ricomputermuseum/RICM_greenpower_telemetry/parts.xlsx

Part | Cost | Quantity | part cost | Link | Notes
Raspberry Pi Pico | $4.00 | 1 | $4.00
I2C Accelerometer/gyro | $3.33 | 1 | $3.33 | https://www.amazon.com/HiLetgo-MPU-6050-Accelerometer-Gyroscope-Converter/dp/B00LP25V1A?hvadid=247487538123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 | $10 for 3 | https://lastminuteengineers.com/mpu6050-accel-gyro-arduino-tutorial/
SD card breakout | $3.00 | 1 | $3.00 | https://www.digikey.com/en/products/detail/adafruit-industries-llc/4682/12822319?WT.mc_id=frommaker.io | Can write directly from the SPI bus
thermistor | $4.00 | 3 | $12.00 | https://www.adafruit.com/product/372 | cheaper and simpler than using a thermocouple
Hall effect sensor | $1.00 | 2 | $2.00 | https://www.digikey.com/en/products/detail/melexis-technologies-nv/US5881LUA-AAA-000-BU/431876 | Can use 1 on the motor or 2 for motor and axle | https://maker.pro/arduino/tutorial/how-to-use-a-hall-effect-sensor-with-arduino
Current Sensor | $25.50 | 1 | $25.50 | https://www.digikey.com/en/products/detail/lem-usa-inc/HAIS-50-P/1026520
Voltage Sensor IC | $6.70 | 1 | $6.70 | https://www.digikey.com/en/products/detail/analog-devices-inc/LTC2990CMS-TRPBF/2407346 | 4 channels, 2 for the battery and 2 for the ref and measurement on the current sensor
Total | $56.53
