ricomputermuseum/RICM_greenpower_telemetry/RICM Greenpower Telemetry Module/RICM Greenpower Instrument Cluster/gerbers/RICM Greenpower Instrument Cluster-Edge_Cuts.dxf

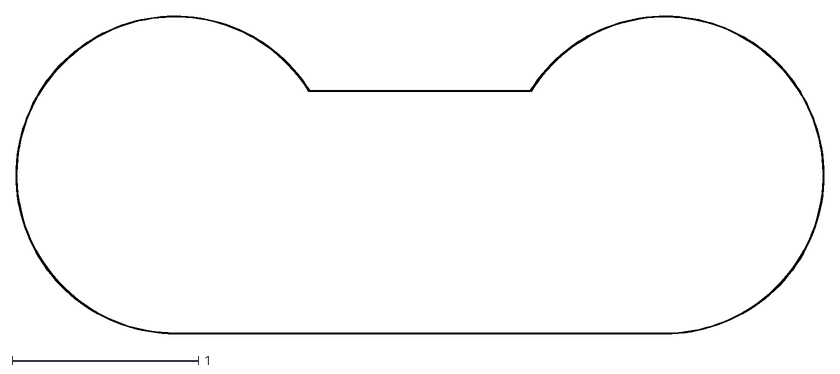
[picture p7: CAD file, 2024-07-16]
RICM Greenpower Telemetry Module/RICM Greenpower Instrument Cluster/gerbers/RICM Greenpower Instrument Cluster-Edge_Cuts.dxf
4.33 x 1.70
