ricomputermuseum/RICM_greenpower_telemetry/(list of files, cad)

Other CAD files:
RICM Greenpower Telemetry Module/RICM Greenpower Instrument Cluster/gerbers/RICM Greenpower Instrument Cluster-F_Mask.dxf
kicad parts/KiCad-RP-Pico-main/SketchUp Model/Pico.skp
