ricomputermuseum/RICM_greenpower_telemetry/pinout_guide.png

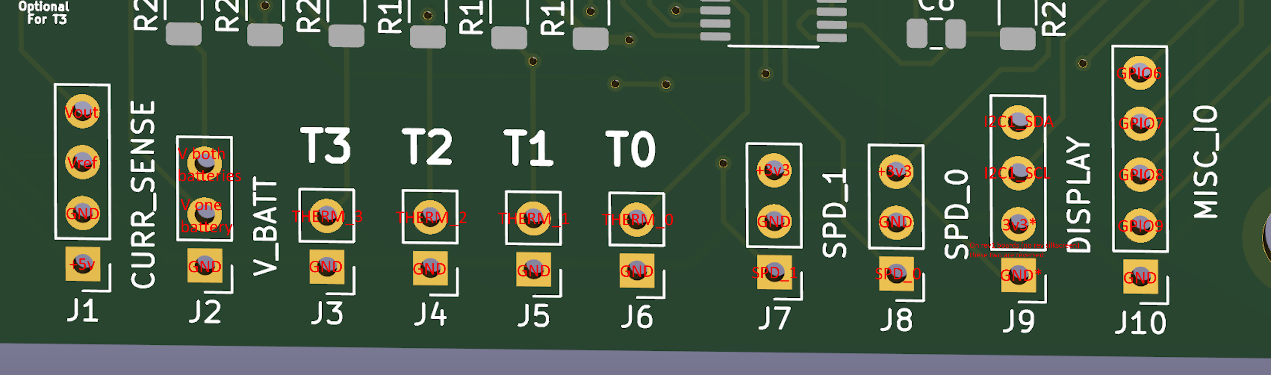
pinout_guide.png
