ricomputermuseum/RICM_greenpower_telemetry/RICM Greenpower Telemetry Module/pinout_guide.png

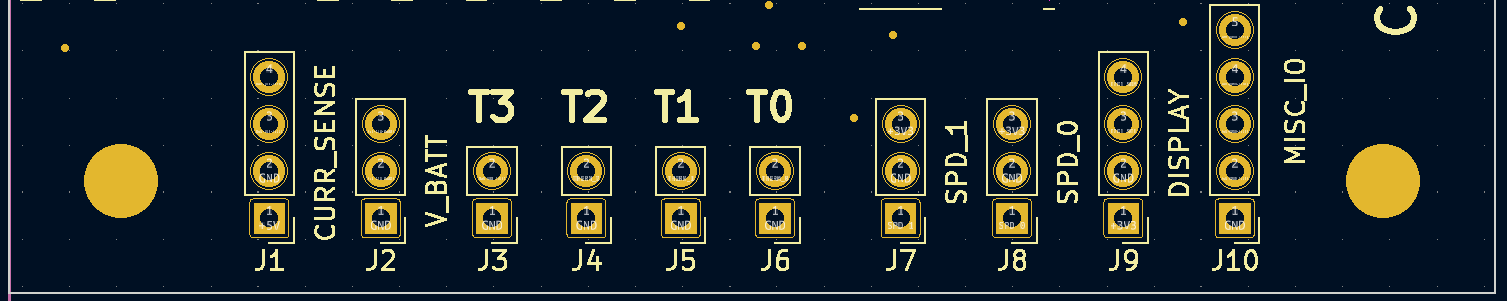
RICM Greenpower Telemetry Module/pinout_guide.png
