ricomputermuseum/RICM_greenpower_telemetry/RICM Greenpower Telemetry Module/RICM Greenpower Telemetry Module.pdf

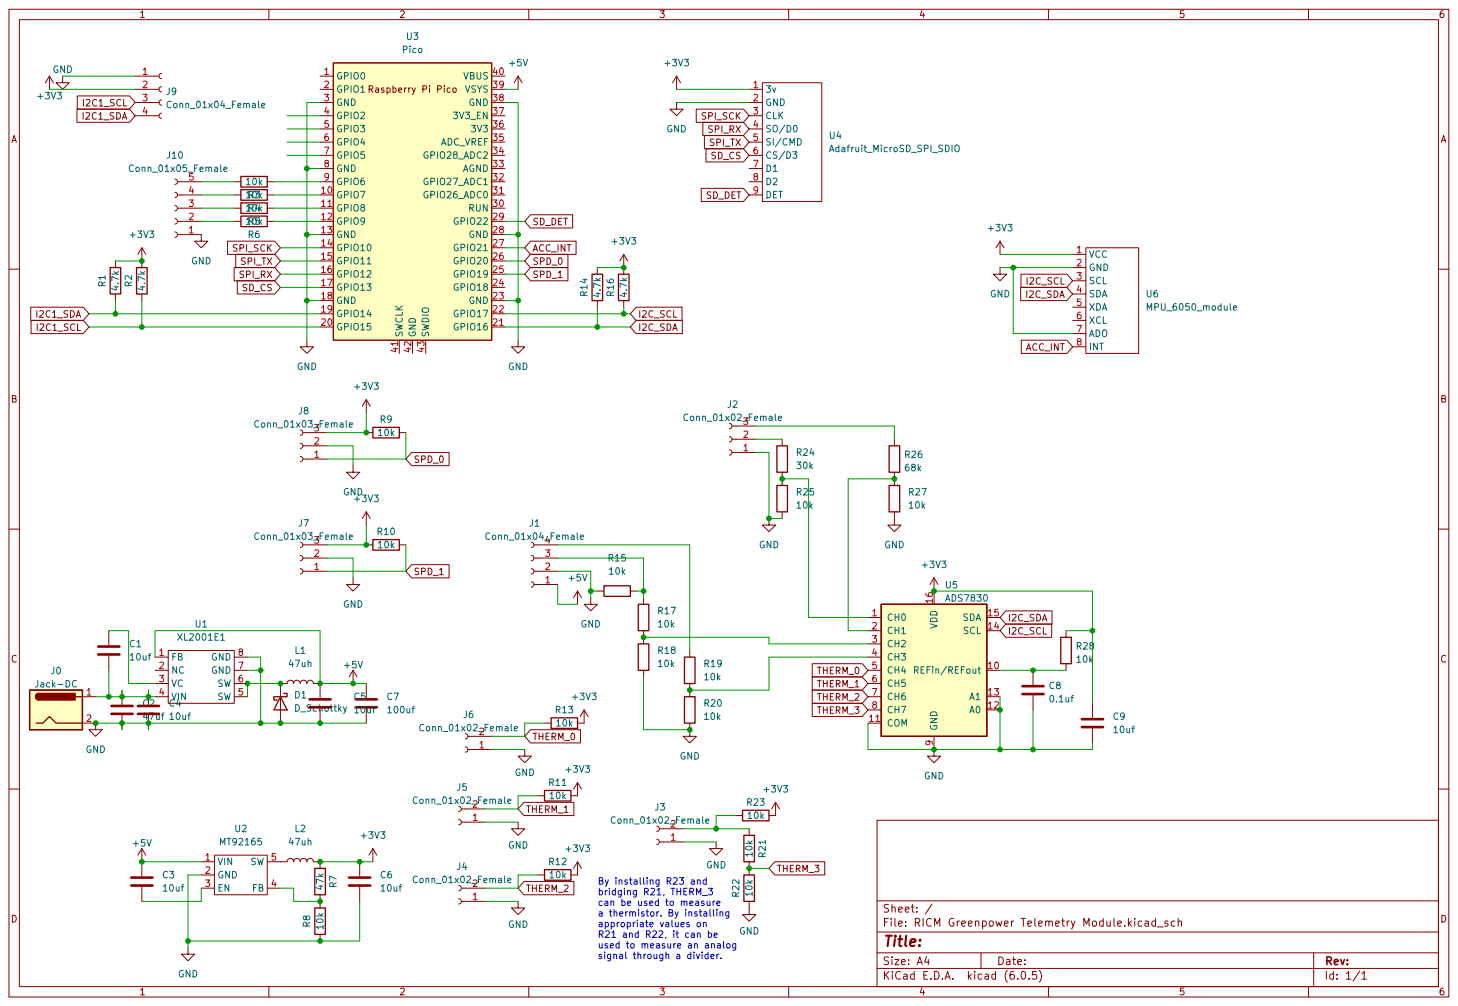
[picture p23: page 1]

File: RICM Greenpower Telemetry Module.kicad_sch Sheet: / +3V3

bridging R21, THERM_3
can be used to measure
a thermistor. By installing
appropriate values on R21 and R22, it can be

used to measure an analog
signal through a divider.
