ricomputermuseum/RICM_greenpower_telemetry/RICM Greenpower Telemetry Module/gerbers/RICM Greenpower Telemetry Module-F_Silkscreen.pdf

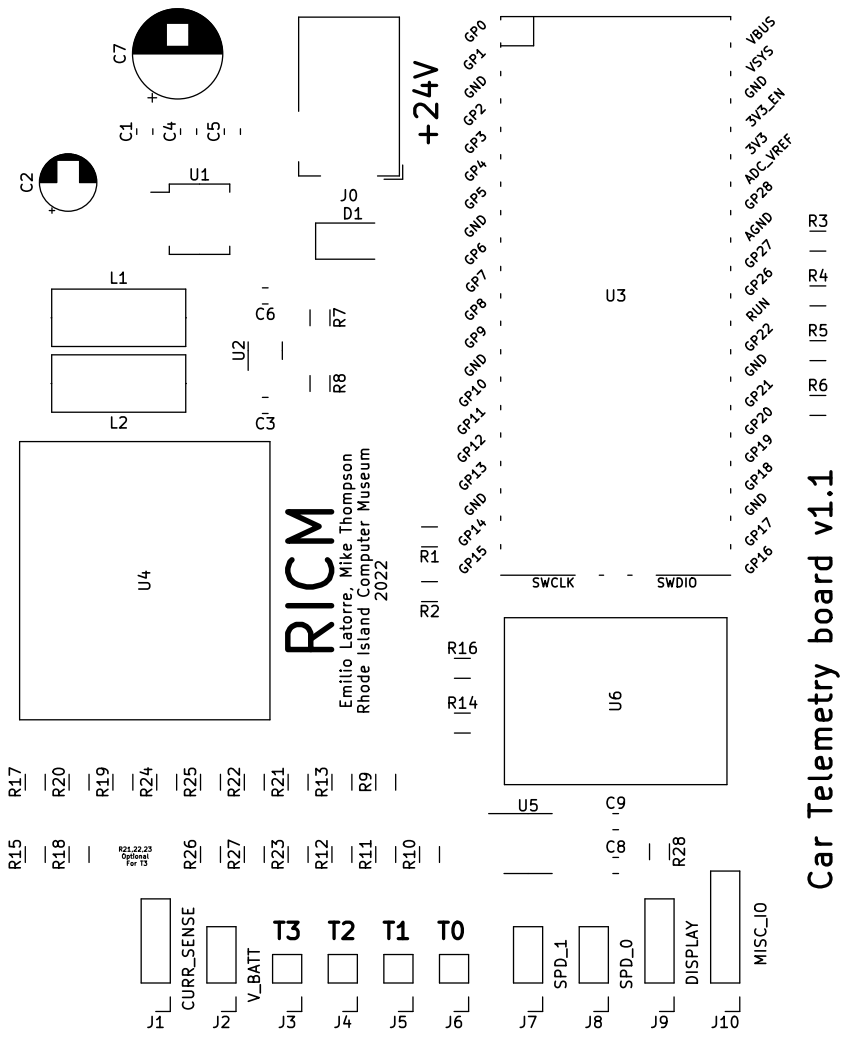
[picture p24: page 1]

DISPLAYT0 Car Telemetry board v1.1 V_BATT Emilio Latorre, Mike Thompson Rhode Island Computer Museum 2022 +24V
