ricomputermuseum/RICM_greenpower_telemetry/kicad parts/KiCad-RP-Pico-main/RP-Pico Libraries/diagram.pdf

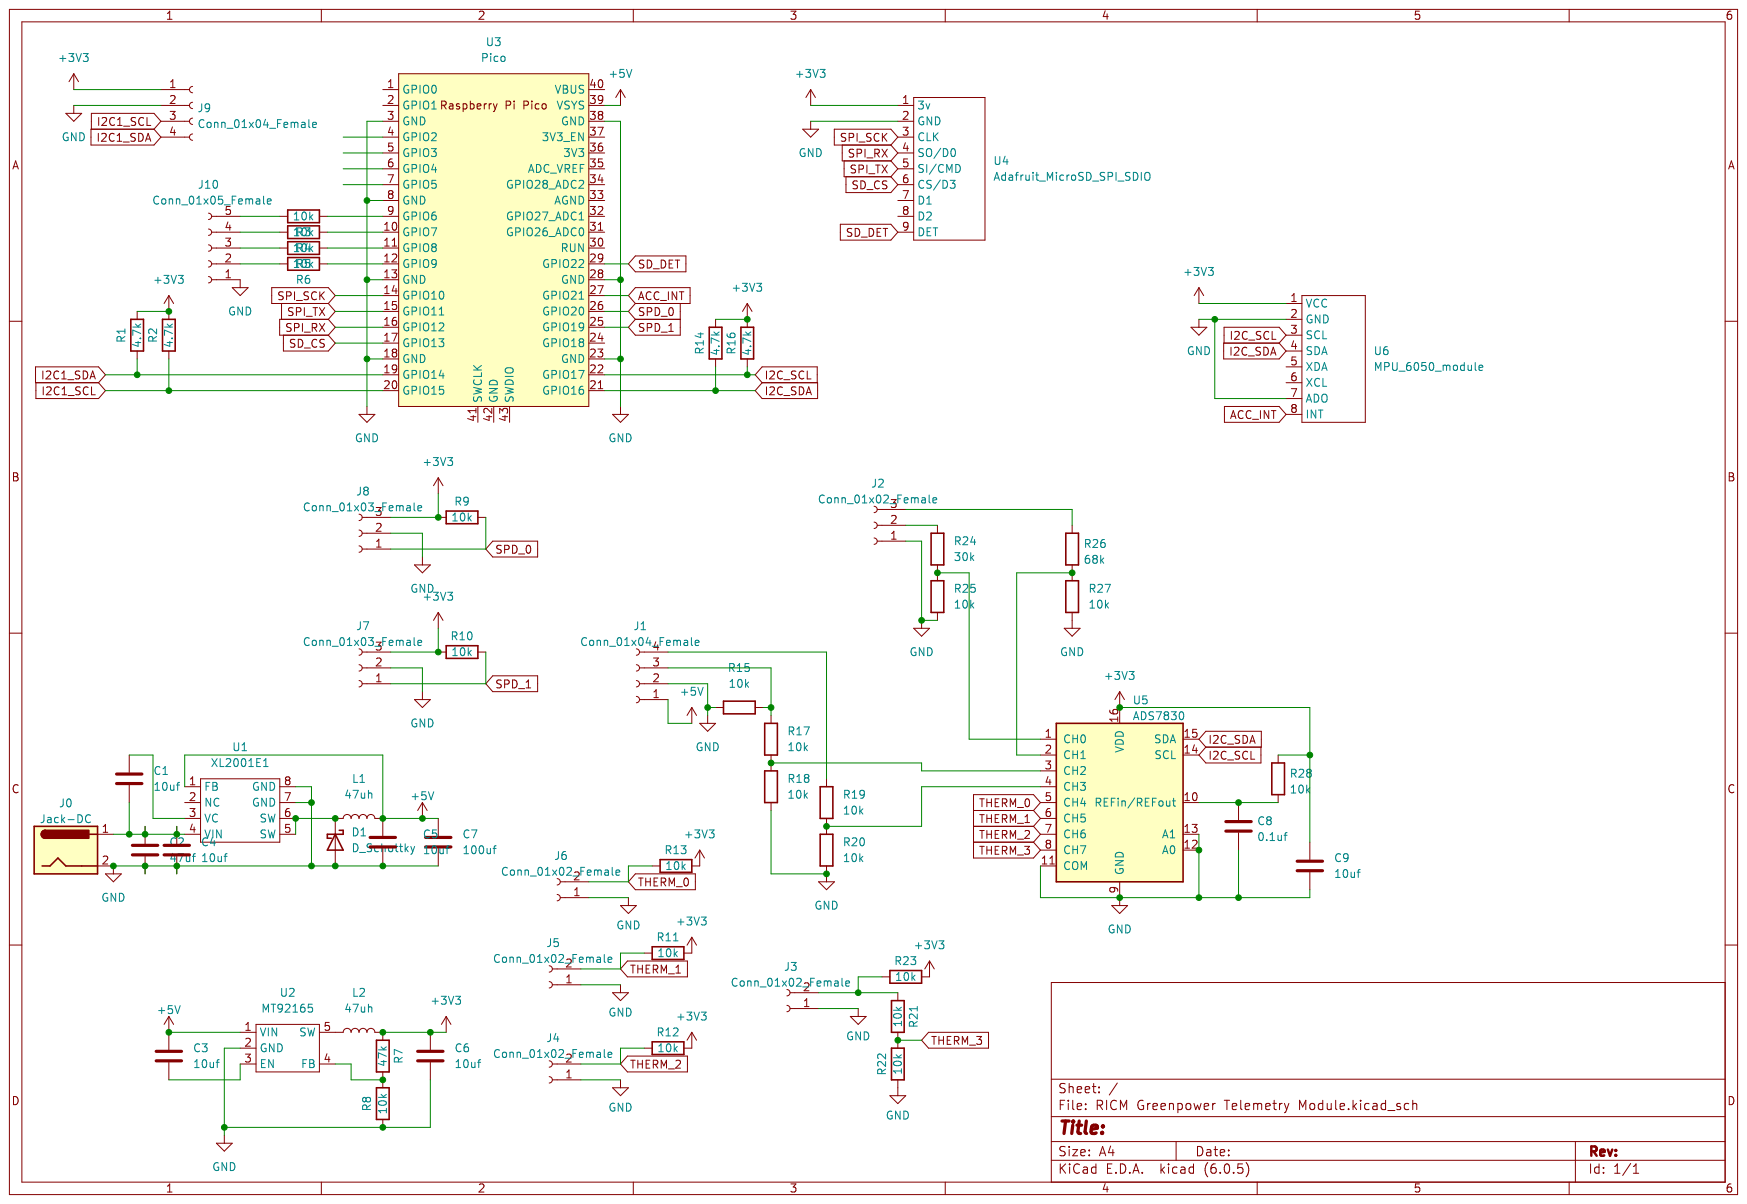
[picture p25: page 1]
