ricomputermuseum/RICM_greenpower_telemetry/RICM Greenpower Telemetry Module/board.pdf

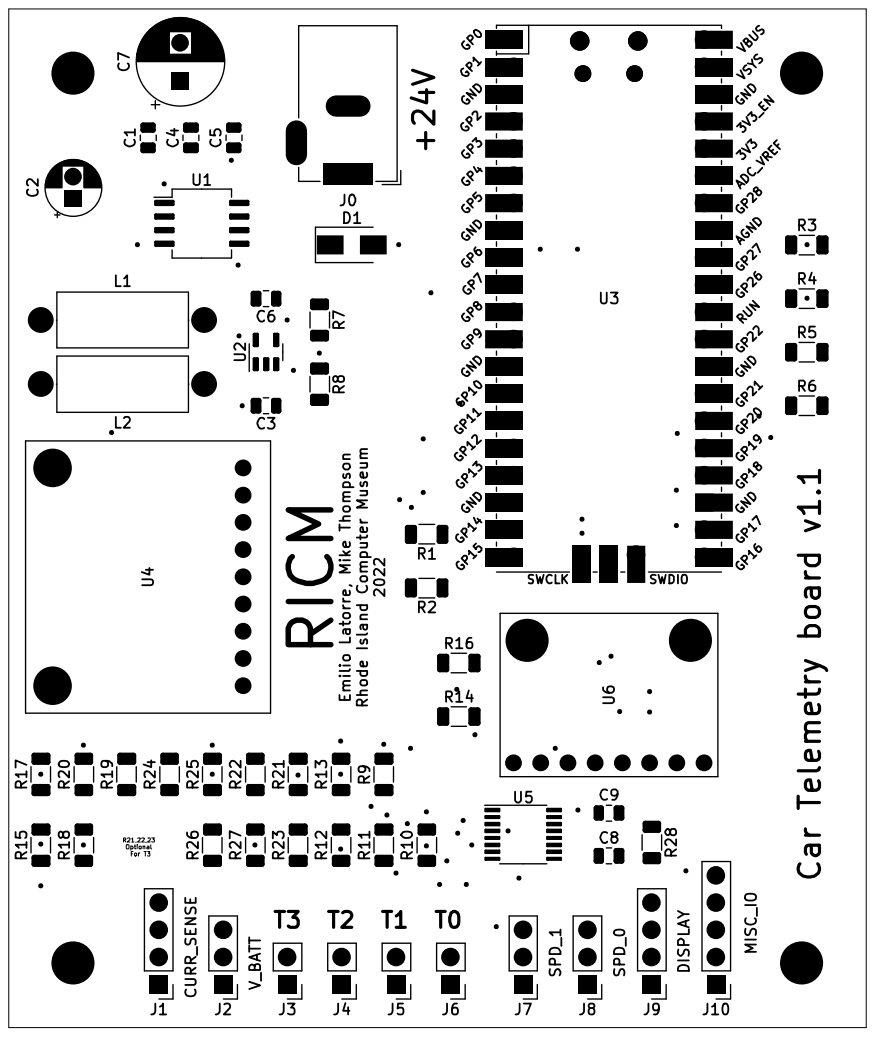
[picture p26: page 1]
