ricomputermuseum/RICM_greenpower_telemetry/RICM Greenpower Telemetry Module/gerbers/RICM Greenpower Telemetry Module-F_Cu.pdf

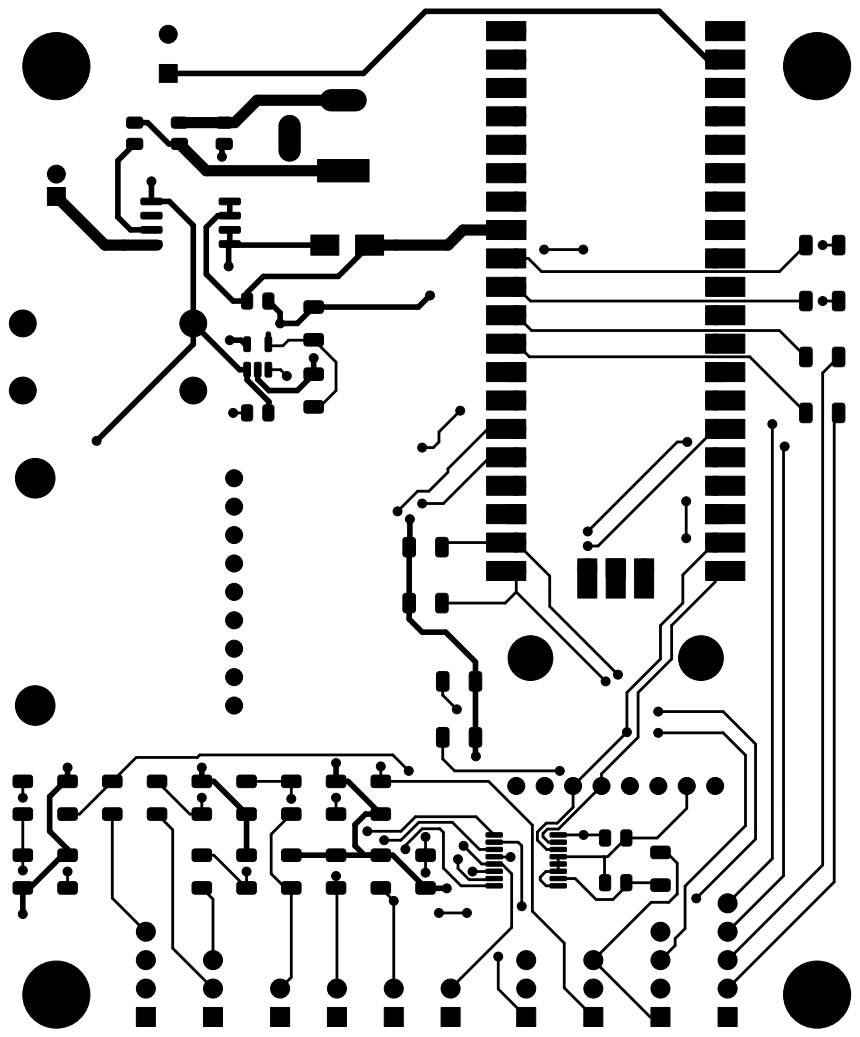
[picture p27: page 1]
