ricomputermuseum/RICM_greenpower_telemetry/RICM Greenpower Telemetry Module/gerbers/RICM Greenpower Telemetry Module-B_Cu.pdf

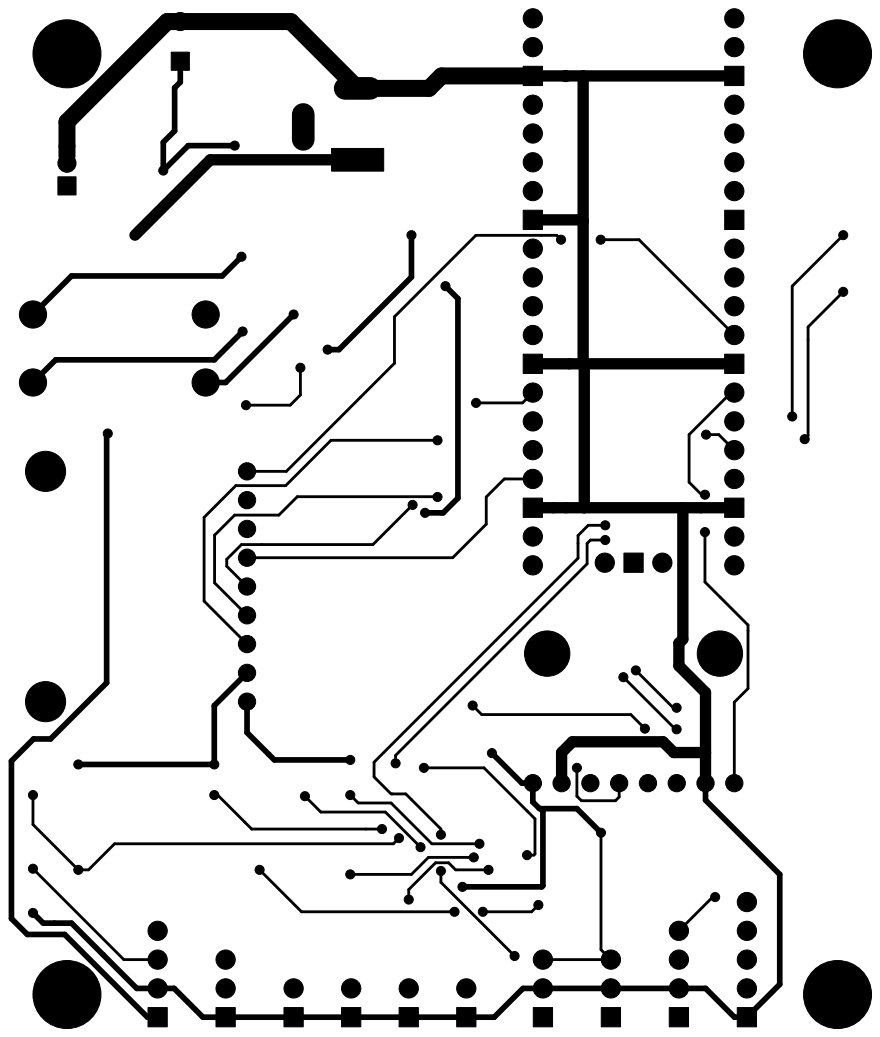
[picture p28: page 1]
