ricomputermuseum/RICM_greenpower_telemetry/RICM Greenpower Telemetry Module/gerbers/RICM Greenpower Telemetry Module-B_Mask.pdf

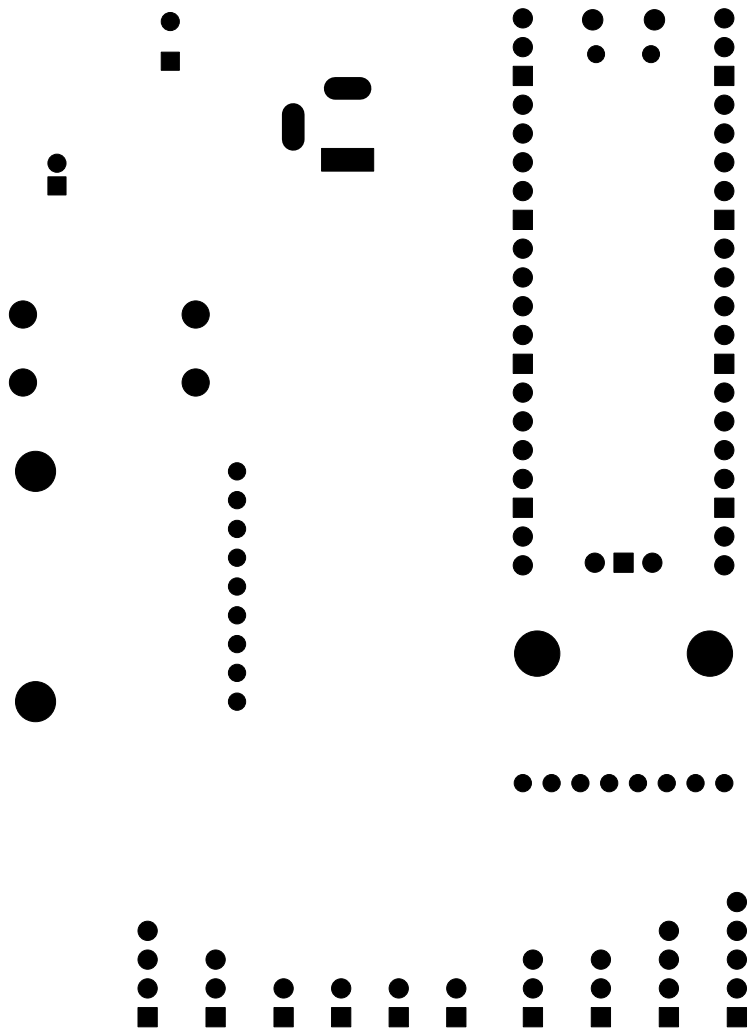
[picture p29: page 1]
