ricomputermuseum/RICM_greenpower_telemetry/RICM Greenpower Telemetry Module/gerbers/RICM Greenpower Telemetry Module-F_Mask.pdf

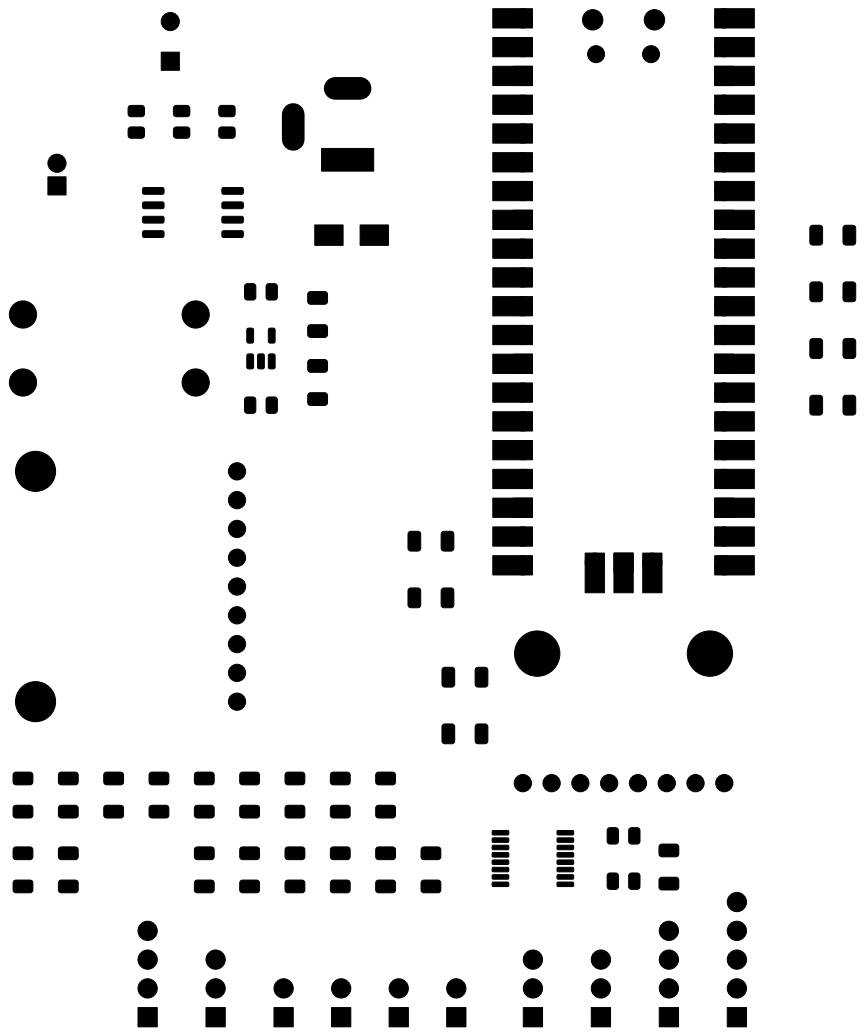
[picture p30: page 1]
