ricomputermuseum/RICM_greenpower_telemetry/RICM Greenpower Telemetry Module/RICM Greenpower Instrument Cluster/RICM Greenpower Instrument Cluster.kicad_pcb

## KiCad design RICM Greenpower Telemetry Module/RICM Greenpower Instrument Cluster/RICM Greenpower Instrument Cluster.kicad_pcb (2024-07-16)

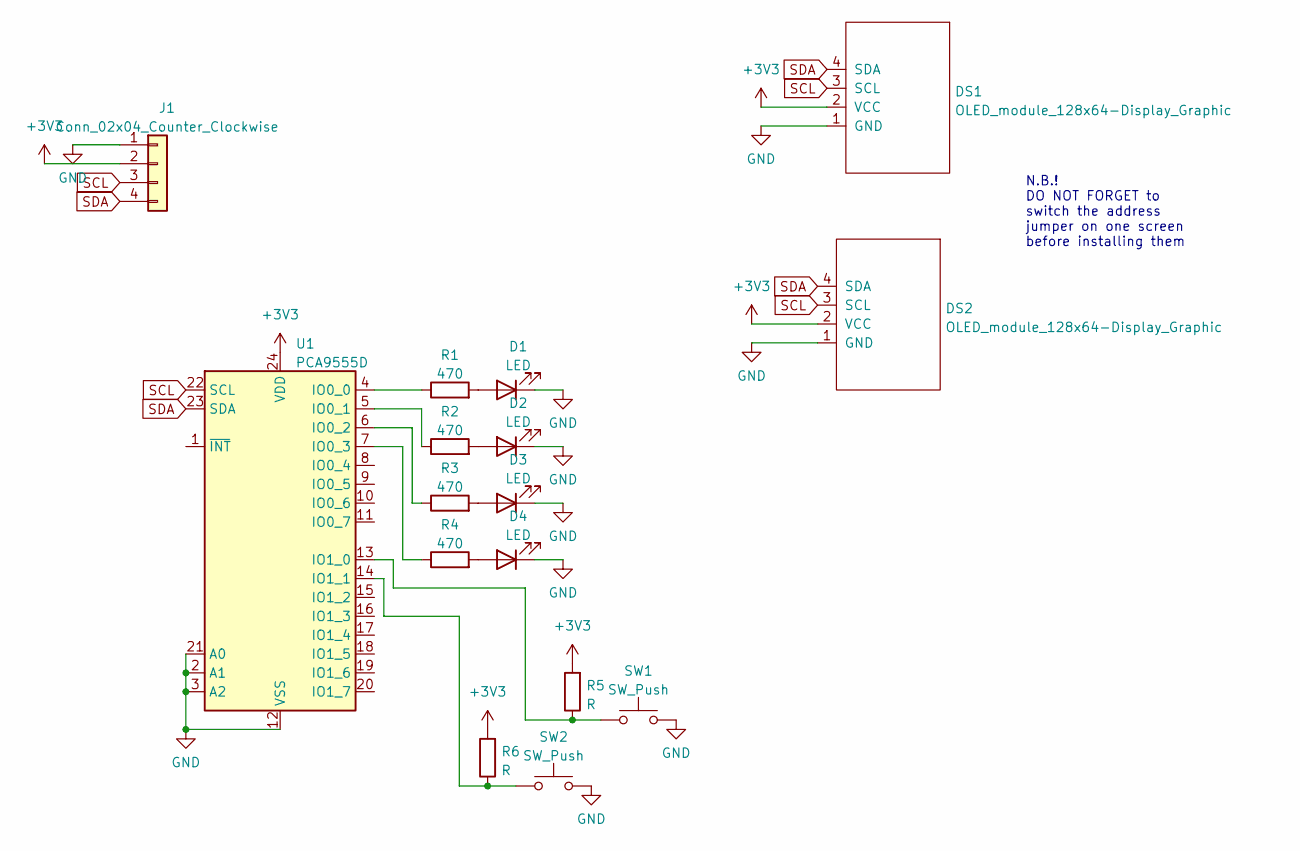
[picture p32: schematic RICM Greenpower Instrument Cluster.kicad_sch]

Parts:
D1, D2, D3, D4: LED; LED_D5.0mm
DS1, DS2: OLED_module_128x64-Display_Graphic; OLED__module_128x64
J1: Conn_02x04_Counter_Clockwise; PinHeader_1x04_P2.54mm_Vertical
R1, R2, R3, R4: 470; R_Axial_DIN0207_L6.3mm_D2.5mm_P7.62mm_Horizontal
R5, R6: R; R_Axial_DIN0207_L6.3mm_D2.5mm_P7.62mm_Horizontal
SW1, SW2: SW_Push; SW_PUSH_6mm_2pin
U1: PCA9555D; SOIC-24W_7.5x15.4mm_P1.27mm

Connections:
+3V3: DS1.2 (VCC), DS2.2 (VCC), J1.2, U1.24 (VDD)
+5V: R5.2, R6.2
GND: D1.1 (K), D2.1 (K), D3.1 (K), D4.1 (K), DS1.1 (GND), DS2.1 (GND), J1.1, SW1.2, SW2.2, U1.2 (A1), U1.3 (A2), U1.12 (VSS), U1.21 (A0)
unnamed: D1.2 (A), R1.2
unnamed: D2.2 (A), R2.2
unnamed: D3.2 (A), R3.2
unnamed: D4.2 (A), R4.2
unnamed: R1.1, U1.4 (IO0_0)
unnamed: R2.1, U1.5 (IO0_1)
unnamed: R3.1, U1.6 (IO0_2)
unnamed: R4.1, U1.7 (IO0_3)
unnamed: R5.1, SW1.1, U1.13 (IO1_0)
unnamed: R6.1, SW2.1, U1.14 (IO1_1)
SCL: DS1.3 (SCL), DS2.3 (SCL), J1.3, U1.22 (SCL)
SDA: DS1.4 (SDA), DS2.4 (SDA), J1.4, U1.23 (SDA)

Notes on the sheet:
N.B.! DO NOT FORGET to switch the address jumper on one screen before installing them

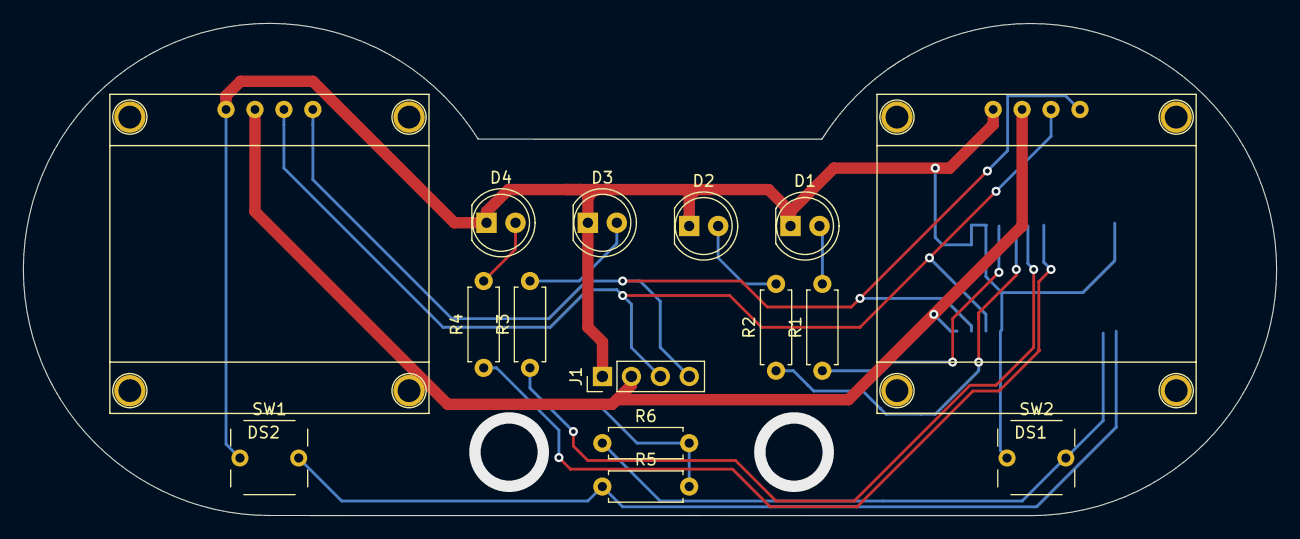
[picture p33: board RICM Greenpower Instrument Cluster.kicad_pcb from above]

Board: 2 copper layers, 110.0 x 43.2 mm, 16 parts (1 on the bottom side), 15 nets.
