ricomputermuseum/RICM_greenpower_telemetry/RICM Greenpower Telemetry Module/RICM Greenpower Telemetry Module.kicad_pcb

## KiCad design RICM Greenpower Telemetry Module/RICM Greenpower Telemetry Module.kicad_pcb (2024-07-16)

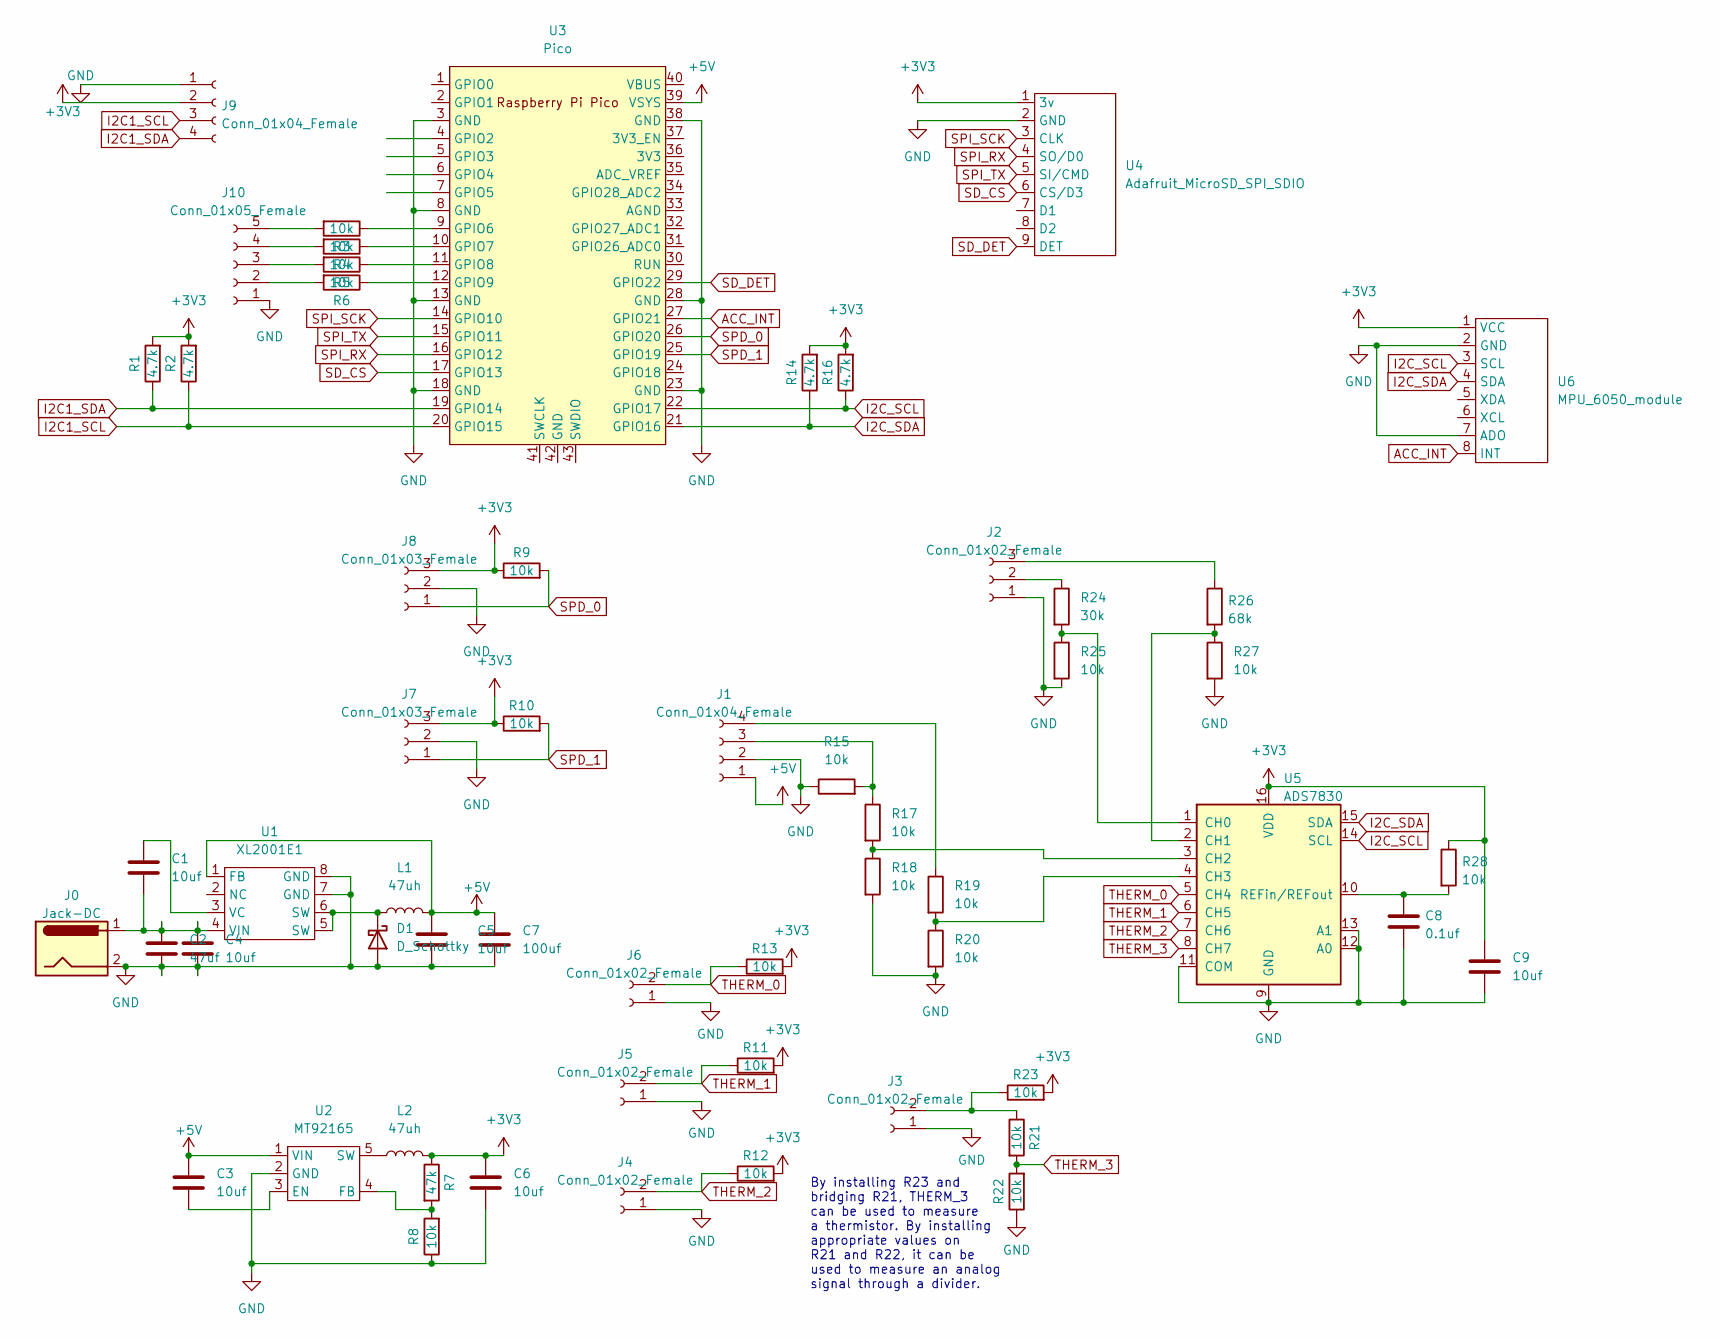
[picture p34: schematic RICM Greenpower Telemetry Module.kicad_sch]

Parts:
C1, C3, C4, C5, C6, C9: 10uf; C_0805_2012Metric
C2: 47uf; CP_Radial_D5.0mm_P2.00mm
C7: 100uf; CP_Radial_D8.0mm_P3.50mm
C8: 0.1uf; C_0805_2012Metric
D1: D_Schottky; D_SMA
J0: Jack-DC; BarrelJack_GCT_DCJ200-10-A_Horizontal
J1, J9: Conn_01x04_Female; PinHeader_1x04_P2.54mm_Vertical
J2: Conn_01x02_Female; PinHeader_1x03_P2.54mm_Vertical
J3, J4, J5, J6: Conn_01x02_Female; PinHeader_1x02_P2.54mm_Vertical
J7, J8: Conn_01x03_Female; PinHeader_1x03_P2.54mm_Vertical
J10: Conn_01x05_Female; PinHeader_1x05_P2.54mm_Vertical
L1, L2: 47uh; L_Axial_L12.0mm_D5.0mm_P15.24mm_Horizontal_Fastron_MISC
R1, R2, R14, R16: 4.7k; R_1206_3216Metric
R3, R4, R5, R6, R8, R9, R10, R11, R12, R13, R15, R17, R18, R19, R20, R21, R22, R23, R25, R27, R28: 10k; R_1206_3216Metric
R7: 47k; R_1206_3216Metric
R24: 30k; R_1206_3216Metric
R26: 68k; R_1206_3216Metric
U1: XL2001E1; SO-8_5.3x6.2mm_P1.27mm
U2: MT92165; SOT-23-5
U3: Pico; RPi_Pico_SMD_TH
U4: Adafruit_MicroSD_SPI_SDIO; Adafruit_MicroSD_breakout
U5: ADS7830; TSSOP-16_4.4x5mm_P0.65mm
U6: MPU_6050_module

Connections:
+3V3: C6.1, C9.1, J7.3, J8.3, J9.2, L2.2, R1.2, R2.2, R7.1, R9.1, R10.1, R11.2, R12.2, R13.2, R14.2, R16.2, R23.2, R28.1, U4.1 (3v), U5.16 (VDD), U6.1 (VCC)
+5V: C3.1, C5.1, C7.1, J1.1, L1.2, U1.1 (FB), U2.1 (VIN), U3.39 (VSYS)
ACC_INT: U3.27 (GPIO21), U6.8 (INT)
GND: C2.2, C4.2, C5.2, C6.2, C7.2, C8.1, C9.2, D1.2 (A), J0.2, J1.2, J2.1, J3.1, J4.1, J5.1, J6.1, J7.2, J8.2, J9.1, J10.1, R8.1, R15.1, R18.2, R20.2, R22.1, R25.2, R27.2, U1.7 (GND), U1.8 (GND), U2.2 (GND), U3.3 (GND), U3.8 (GND), U3.13 (GND), U3.18 (GND), U3.23 (GND), U3.28 (GND), U3.38 (GND), U4.2 (GND), U5.9 (GND), U5.11 (COM), U5.12 (A0), U5.13 (A1), U6.2 (GND), U6.7 (ADO)
I2C1_SCL: J9.3, R2.1, U3.20 (GPIO15)
I2C1_SDA: J9.4, R1.1, U3.19 (GPIO14)
I2C_SCL: R16.1, U3.22 (GPIO17), U5.14 (SCL), U6.3 (SCL)
I2C_SDA: R14.1, U3.21 (GPIO16), U5.15 (SDA), U6.4 (SDA)
unnamed: C1.1, U1.3 (VC)
unnamed: C1.2, C2.1, C4.1, J0.1, U1.4 (VIN)
unnamed: C3.2, U2.3 (EN)
unnamed: C8.2, R28.2, U5.10 (REFin/REFout)
unnamed: D1.1 (K), L1.1, U1.5 (SW), U1.6 (SW)
unnamed: J1.3, R15.2, R17.1
unnamed: J1.4, R19.1
unnamed: J2.2, R24.1
unnamed: J2.3, R26.1
unnamed: J3.2, R21.1, R23.1
unnamed: J10.2, R6.2
unnamed: J10.3, R5.2
unnamed: J10.4, R4.2
unnamed: J10.5, R3.2
unnamed: L2.1, U2.5 (SW)
unnamed: R3.1, U3.9 (GPIO6)
unnamed: R4.1, U3.10 (GPIO7)
unnamed: R5.1, U3.11 (GPIO8)
unnamed: R6.1, U3.12 (GPIO9)
unnamed: R7.2, R8.2, U2.4 (FB)
unnamed: R17.2, R18.1, U5.3 (CH2)
unnamed: R19.2, R20.1, U5.4 (CH3)
unnamed: R24.2, R25.1, U5.1 (CH0)
unnamed: R26.2, R27.1, U5.2 (CH1)
SD_CS: U3.17 (GPIO13), U4.6 (CS/D3)
SD_DET: U3.29 (GPIO22), U4.9 (DET)
SPD_0: J8.1, R9.2, U3.26 (GPIO20)
SPD_1: J7.1, R10.2, U3.25 (GPIO19)
SPI_RX: U3.16 (GPIO12), U4.4 (SO/D0)
SPI_SCK: U3.14 (GPIO10), U4.3 (CLK)
SPI_TX: U3.15 (GPIO11), U4.5 (SI/CMD)
THERM_0: J6.2, R13.1, U5.5 (CH4)
THERM_1: J5.2, R11.1, U5.6 (CH5)
THERM_2: J4.2, R12.1, U5.7 (CH6)
THERM_3: R21.2, R22.2, U5.8 (CH7)

Notes on the sheet:
By installing R23 and bridging R21, THERM_3 can be used to measure a thermistor. By installing appropriate values on R21 and R22, it can be used to measure an analog signal through a divider.

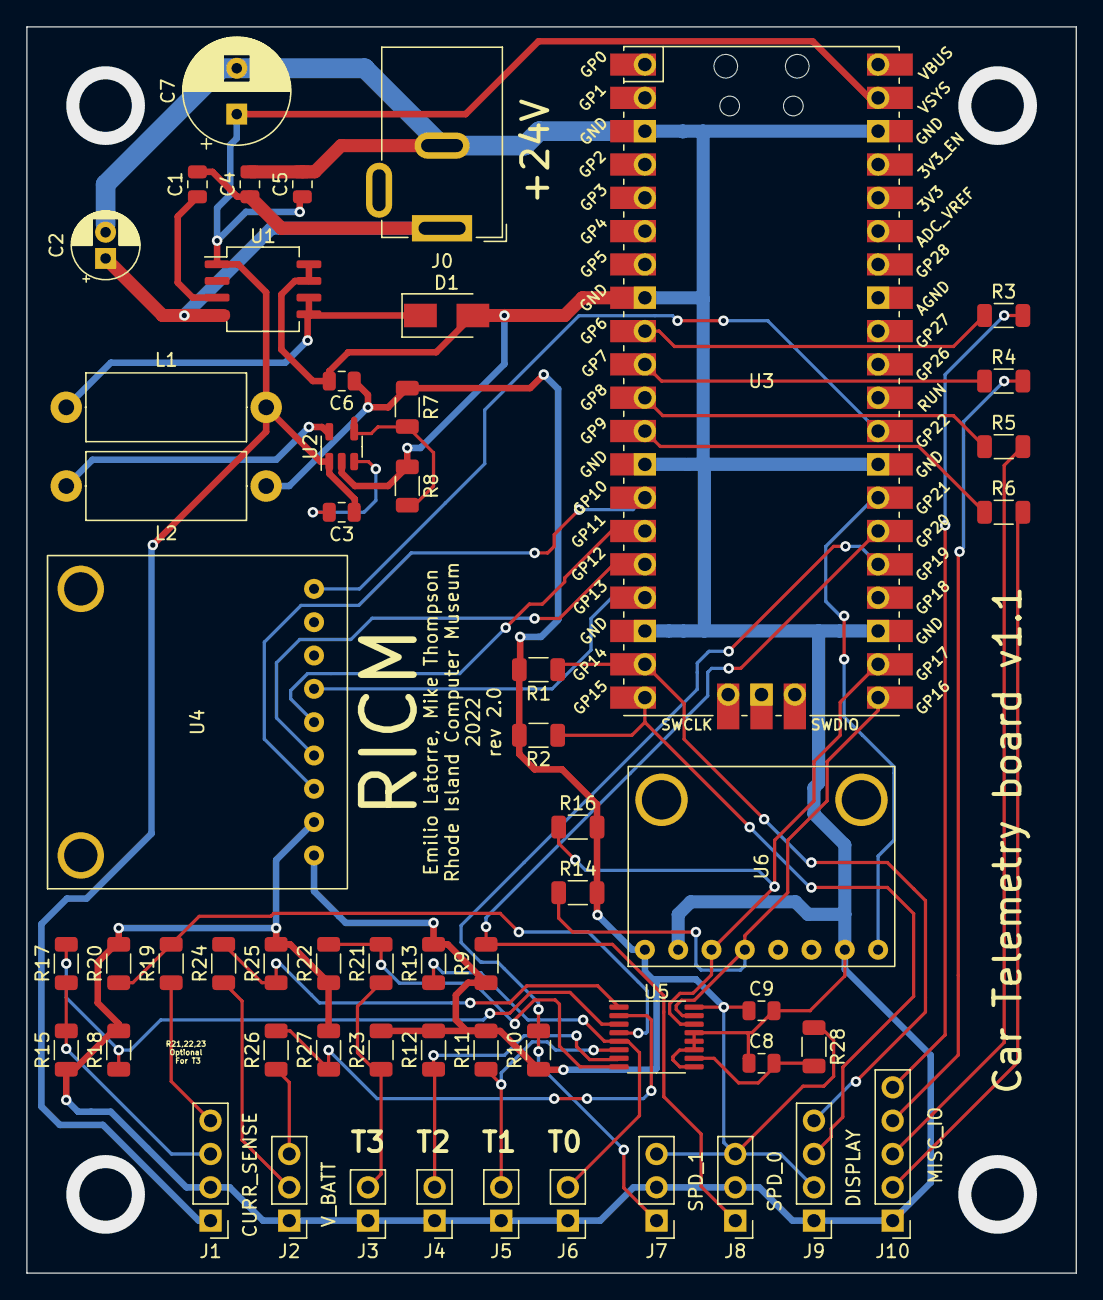
[picture p35: board RICM Greenpower Telemetry Module.kicad_pcb from above]

Board: 2 copper layers, 80.0 x 95.0 mm, 57 parts (0 on the bottom side), 43 nets.
