ricomputermuseum/RICM_greenpower_telemetry/kicad parts/KiCad-RP-Pico-main/Test/Test.kicad_pcb

## KiCad design kicad parts/KiCad-RP-Pico-main/Test/Test.kicad_pcb (2022-05-19)


Parts:
J1, J2: Conn_01x20; PinSocket_1x20_P1.00mm_Vertical
J3: Conn_01x03; PinSocket_1x03_P1.00mm_Vertical
U1: Pico; RPi_Pico_SMD_TH

Connections:
GND: J1.3, J1.8, J1.13, J1.18, J2.3, J2.13, J2.18, J3.2, U1.3 (GND), U1.8 (GND), U1.13 (GND), U1.18 (GND), U1.23 (GND), U1.28 (GND), U1.38 (GND), U1.42 (GND)
unnamed: J1.1, U1.1 (GPIO0)
unnamed: J1.2, U1.2 (GPIO1)
unnamed: J1.4, U1.4 (GPIO2)
unnamed: J1.5, U1.5 (GPIO3)
unnamed: J1.6, U1.6 (GPIO4)
unnamed: J1.7, U1.7 (GPIO5)
unnamed: J1.9, U1.9 (GPIO6)
unnamed: J1.10, U1.10 (GPIO7)
unnamed: J1.11, U1.11 (GPIO8)
unnamed: J1.12, U1.12 (GPIO9)
unnamed: J1.14, U1.14 (GPIO10)
unnamed: J1.15, U1.15 (GPIO11)
unnamed: J1.16, U1.16 (GPIO12)
unnamed: J1.17, U1.17 (GPIO13)
unnamed: J1.19, U1.19 (GPIO14)
unnamed: J1.20, U1.20 (GPIO15)
unnamed: J2.1, U1.40 (VBUS)
unnamed: J2.2, U1.39 (VSYS)
unnamed: J2.4, U1.37 (3V3_EN)
unnamed: J2.5, U1.36 (3V3)
unnamed: J2.6, U1.35 (ADC_VREF)
unnamed: J2.7, U1.34 (GPIO28_ADC2)
unnamed: J2.8, U1.33 (AGND)
unnamed: J2.9, U1.32 (GPIO27_ADC1)
unnamed: J2.10, U1.31 (GPIO26_ADC0)
unnamed: J2.11, U1.30 (RUN)
unnamed: J2.12, U1.29 (GPIO22)
unnamed: J2.14, U1.27 (GPIO21)
unnamed: J2.15, U1.26 (GPIO20)
unnamed: J2.16, U1.25 (GPIO19)
unnamed: J2.17, U1.24 (GPIO18)
unnamed: J2.19, U1.22 (GPIO17)
unnamed: J2.20, U1.21 (GPIO16)
unnamed: J3.1, U1.43 (SWDIO)
unnamed: J3.3, U1.41 (SWCLK)


Board: 2 copper layers, 43.0 x 65.0 mm, 4 parts (0 on the bottom side), 36 nets.
