ricomputermuseum/RICM_greenpower_telemetry/software_arduino/main/display_assets.h

const uint8_t PROGMEM logo_bitmap_RICM[1024]={
0xFF, 0xFF, 0xFF, 0xFF, 0xFF, 0xFF, 0xFF, 0xFF, 0xFF, 0xFF, 0xFF, 0xFF, 0xFF, 0xFF, 0xFF, 0xFF,
0xFF, 0xFF, 0xFF, 0xFF, 0xFF, 0xFF, 0xFF, 0xFF, 0xFF, 0xFF, 0xFF, 0xFF, 0xFF, 0xFF, 0xFF, 0xFF,
0xFF, 0xFF, 0xFF, 0xFF, 0xFF, 0xFF, 0xFF, 0xFF, 0xFF, 0xFF, 0xFF, 0xFF, 0xFF, 0xFF, 0xFF, 0xFF,
0xFF, 0xFF, 0xFF, 0xFF, 0xFF, 0xFF, 0xFF, 0xFF, 0xFF, 0xFF, 0xFF, 0xFF, 0xFF, 0xFF, 0xFF, 0xFF,
0xFF, 0xFF, 0xFF, 0xFF, 0xFF, 0xFF, 0xFF, 0xFF, 0xFF, 0xFF, 0xFF, 0xFF, 0xFF, 0xFF, 0xFF, 0xFF,
0xFF, 0xFF, 0xFF, 0xFF, 0xFF, 0xFF, 0xFF, 0xFF, 0xFF, 0xFF, 0xFF, 0xFF, 0xFF, 0xFF, 0xFF, 0xFF,
0xFF, 0xFF, 0xFF, 0xFF, 0xFF, 0xFF, 0xFF, 0xFF, 0xFF, 0xFF, 0xFF, 0xFF, 0xFF, 0xFF, 0xFF, 0xFF,
0xFF, 0xFF, 0xFF, 0xFF, 0xFF, 0xFF, 0xFF, 0xFF, 0xFF, 0xFF, 0xFF, 0xFF, 0xFF, 0xFF, 0xFF, 0xFF,
0xFF, 0xFF, 0xFF, 0xFF, 0xFF, 0xFF, 0xFF, 0xFF, 0xC0, 0x3F, 0xFF, 0xFF, 0xFF, 0xFF, 0xFF, 0xFF,
0xFF, 0x80, 0x00, 0x7F, 0xFF, 0x00, 0xFF, 0xFF, 0x00, 0x0F, 0xFC, 0x00, 0xFF, 0xF8, 0x01, 0xFF,
0xFF, 0x80, 0x00, 0x1F, 0xFF, 0x00, 0xFF, 0xFC, 0x00, 0x03, 0xFC, 0x00, 0xFF, 0xF8, 0x01, 0xFF,
0xFF, 0x80, 0x00, 0x07, 0xFF, 0x00, 0xFF, 0xF8, 0x00, 0x01, 0xFC, 0x00, 0xFF, 0xF8, 0x01, 0xFF,
0xFF, 0x80, 0x00, 0x03, 0xFF, 0x00, 0xFF, 0xF0, 0x00, 0x01, 0xFC, 0x00, 0x7F, 0xF0, 0x01, 0xFF,
0xFF, 0x80, 0x00, 0x03, 0xFF, 0x00, 0xFF, 0xE0, 0x00, 0x01, 0xFC, 0x00, 0x7F, 0xF0, 0x01, 0xFF,
0xFF, 0x80, 0x00, 0x01, 0xFF, 0x00, 0xFF, 0xC0, 0x00, 0x01, 0xFC, 0x00, 0x7F, 0xF0, 0x01, 0xFF,
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
0xFF, 0xFF, 0xFF, 0xFF, 0xFF, 0xE1, 0xFF, 0x8F, 0x83, 0xFC, 0x03, 0xFF, 0xFF, 0xFF, 0xFF, 0xFF,
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
};

const char disp_labels[][16] = {"speed","rpm","vBat0","vBat1","current","temp0","temp1","temp2","temp3","accX","accY","accZ","gyroX","gyroY","gyroZ","time"};
