ricomputermuseum/RICM_greenpower_telemetry/software_arduino/main/thermistor.h

//N.B. these values are calculated for an MF52-103J3950 thermistor with r25 of 10k
//if you use a different thermistor you will have to recalculate and update these values
//as thermistors are aggressively nonlinear (quartic is a good approximation) it is much cheaper computationally to use this table instead of calculating the temperature
//additionally because of this nonlinearity temperatures below 0*C cannot be accurately measured with an 8-bit reading
const float therm_readings[256] ={
    150.00,
    145.82,
    141.81,
    137.96,
    134.27,
    130.74,
    127.35,
    124.10,
    120.99,
    118.01,
    115.16,
    112.43,
    109.81,
    107.30,
    104.90,
    102.59,
    100.39,
    98.28,
    96.26,
    94.32,
    92.47,
    90.69,
    88.99,
    87.36,
    85.79,
    84.29,
    82.86,
    81.48,
    80.15,
    78.88,
    77.66,
    76.48,
    75.35,
    74.27,
    73.22,
    72.21,
    71.24,
    70.31,
    69.40,
    68.53,
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
};
