ricomputermuseum/RICM_greenpower_telemetry/(commit log)

2022-05-19 started on a layout
    [Pico.skp, RICM Greenpower Telemetry Module.kicad_pcb, RICM Greenpower Telemetry Module.kicad_sch, Test.kicad_pcb, Test.kicad_sch, parts.xlsx]
2022-05-20 added most of the sensors we will probably want
    3x temperature sensors
    2x hall effect (for RPM)
    2x battery voltage
    1x current (inductive loop, 50A)
    1x 3-axis gyro
    1x 3-axis accelerometer
    [RICM Greenpower Telemetry Module.kicad_sch, parts.xlsx]
2022-05-21 added more sensors and connectors
    Added all the sensors and connectors that will go on this board (for now). Next step, layout
    [RICM Greenpower Telemetry Module.kicad_pcb, RICM Greenpower Telemetry Module.kicad_sch]
2022-05-22 bug fixes and missing connections
    Fixed the short from the first battery voltage to ground
    Added a chip select for interfacing the SD card over SPI
    [RICM Greenpower Telemetry Module.kicad_pcb, RICM Greenpower Telemetry Module.kicad_sch]
2022-05-23 first draft of layout
    [RICM Greenpower Telemetry Module.kicad_pcb, RICM Greenpower Telemetry Module.kicad_sch]
2022-05-24 Polyfuse and missing connections
    [RICM Greenpower Telemetry Module.kicad_pcb, RICM Greenpower Telemetry Module.kicad_sch]
2022-06-07 laid out dial cluster
    [RICM Greenpower Instrument Cluster.kicad_pcb, RICM Greenpower Instrument Cluster.kicad_sch]
2022-07-13 update cluster
    Updated cluster schematic to use an I2C gpio expander. Added two pushbutton switches.
    [RICM Greenpower Instrument Cluster.kicad_pcb, RICM Greenpower Telemetry Module.kicad_pcb, RICM Greenpower Telemetry Module.kicad_sch, parts.xlsx]
2022-07-30 added onboard regulator
    Added onboard regulator and associated components. Added 4th thermistor connector.
    [RICM Greenpower Telemetry Module.kicad_pcb, RICM Greenpower Telemetry Module.kicad_sch]
2022-08-05 rearranged board to fit regulator
    [RICM Greenpower Telemetry Module-B_Cu.gbr, RICM Greenpower Telemetry Module-B_Mask.gbr, RICM Greenpower Telemetry Module-B_Paste.gbr, RICM Greenpower Telemetry Module-B_Silkscreen.gbr, RICM Greenpower Telemetry Module-Edge_Cuts.gbr, RICM Greenpower Telemetry Module-F_Cu.gbr, RICM Greenpower Telemetry Module-F_Mask.gbr, RICM Greenpower Telemetry Module-F_Paste.gbr]
2022-08-06 tightened up spacing on the board
    [RICM Greenpower Telemetry Module.kicad_pcb, RICM Greenpower Telemetry Module.kicad_sch]
2022-08-08 last revisions before first order
    [RICM Greenpower Instrument Cluster-B_Cu.gbr, RICM Greenpower Instrument Cluster-B_Mask.gbr, RICM Greenpower Instrument Cluster-B_Paste.gbr, RICM Greenpower Instrument Cluster-B_Silkscreen.gbr, RICM Greenpower Instrument Cluster-Edge_Cuts.gbr, RICM Greenpower Instrument Cluster-F_Cu.gbr, RICM Greenpower Instrument Cluster-F_Mask.gbr, RICM Greenpower Instrument Cluster-F_Paste.gbr]
2022-08-08 Added pullups for i2c
    [RICM Greenpower Telemetry Module.kicad_pcb, RICM Greenpower Telemetry Module.kicad_sch]
2022-08-08 started work on software
    Copied over the libraries for the gpio and oled modules. Added a library for the ADC chip. Started working on a module for the hall effect speedometer.
2022-08-09 more libraries
    Worked on the hall sensor and added a library for the thermistor.
2022-08-12 rearranged board
    Switched to sdm resistors and capacitors. Added a 3v3 regulated supply. Various other revisions.
    [RICM Greenpower Telemetry Module.kicad_pcb, RICM Greenpower Telemetry Module.kicad_sch]
2022-09-03 Moving to laptop
    [RICM Greenpower Telemetry Module-B_Cu.gbr, RICM Greenpower Telemetry Module-B_Mask.gbr, RICM Greenpower Telemetry Module-B_Paste.gbr, RICM Greenpower Telemetry Module-B_Silkscreen.gbr, RICM Greenpower Telemetry Module-Edge_Cuts.gbr, RICM Greenpower Telemetry Module-F_Cu.gbr, RICM Greenpower Telemetry Module-F_Mask.gbr, RICM Greenpower Telemetry Module-F_Paste.gbr]
2022-10-23 Updates to ADC, gyro, thermistor libraries
2022-10-23 fixed errors discovered in v1 board
    Connected vref on the ADS7830 to 3v3.
    Corrected swapped pins on MT9216.
    Added silkscreens and readjusted connector numbering.
    [RICM Greenpower Telemetry Module.kicad_pcb, RICM Greenpower Telemetry Module.kicad_sch]
2022-11-21 work on thermistor calculation
2022-12-04 added diags, bugfixes
    Added libraries and associated diagnostics for OLED screens and GPIO buttons.
    [RICM Greenpower Telemetry Module.kicad_sch]
2023-01-24 Updates to SD card
    Added library for SD card and began work on library for CSV formatting
    [hello_world.csv]
2023-01-25 SD card read and write working
    SD card wrapper now writes and reads correctly
    [CSV.py, SD.py]
2023-04-11 PDF of main circuit diagram
2023-04-19 added BOMs from LCSC
    [LCSC_Exported_20221023_212201.csv, LCSC_Exported__20230411_222559.csv]
2024-01-13 Fixed footprints and silkscreen
    [RICM Greenpower Telemetry Module.kicad_pcb, RICM Greenpower Telemetry Module.kicad_sch]
2024-01-16 updated hall library
    Moved hall library to an interrupt-updated interval calculation
2024-07-11 Moving to Arduino Core
    Moving from Micropython to Arduino core. Better library support, runs faster, and better tutorials and example code available for when the students want to edit it later.
    Set out a main outline with scheduling and debug prints.
2024-07-12 SD card datalogging
    SD card data logging added. Data from all sensors is logged in CSV format with stamp of elapsed time since last reset.
    0s are entered for sensors that are not reading or have not yet been configured.
    [main.ino]
2024-07-12 Thermistor temperature array
    Calculated and added thermistor temperature values in a header. As the equation of temperature-resistance for the thermistor is roughly quartic, the adc is only 8 bits, and we have a large amount of memory available, it makes sense to just calculate and store the temperature for each reading of the adc. As the adc is not particularly accurate, all temperatures are stored rounded to the nearest degree. Temperature in degrees celcius.
2024-07-14 Added ADC and thermistor support
    Set up the ADS7830 ADC on the board. Added function for reading NTC thermistors as wired on the board and converting the reading to a celcius temperature for logging. Recalculated and corrected thermistor lookup table temperatures.
    [main.ino, thermistor.h]
2024-07-14 Hall effect sensors working
    Created functionality for reading a periodic signal from a hall effect sensor and associated functions to convert to RPM and speed for logging.
2024-07-14 Added Battery and Current measurements
    Added functionality for measuring battery voltages through the ADC chip and current using the current sensor.
2024-07-16 Gyro/accelerometer support
    Added support for reading accelerometer and gyroscopic data on the MPU6050 chip
2024-07-16 Schematic and layout corrections
    Added revision silkscreen to schematic. Fixed pinout of display connector to match standard i2c pinout. Added schematic notes explaining resistor options for THERM_3.
    [RICM Greenpower Telemetry Module.kicad_pcb, RICM Greenpower Telemetry Module.kicad_sch]
2024-07-16 Similar corrections for display module
    Fixed pinout and updated silkscreen and notes for the display module schematic and board.
    [RICM Greenpower Instrument Cluster.kicad_pcb, RICM Greenpower Instrument Cluster.kicad_sch]
2024-07-16 Added display support
    Added support for the OLEDS, buttons, and LEDS on the display module.
    [RICM Greenpower Instrument Cluster-Edge_Cuts.dxf, RICM Greenpower Instrument Cluster-F_Mask.dxf]
